MatiasBarreto93/GrupoO-TT/README.md

# GrupoO-TT
Proyecto Final - Ajedrez - Tecnicatura Superior en Programacion - Metodologia de la Investigacion 2022 - UTN Mendoza
