MatiasBarreto93/GrupoO-TT/Covid/Visera Plana/Visera_plana_rapida_1.pdf

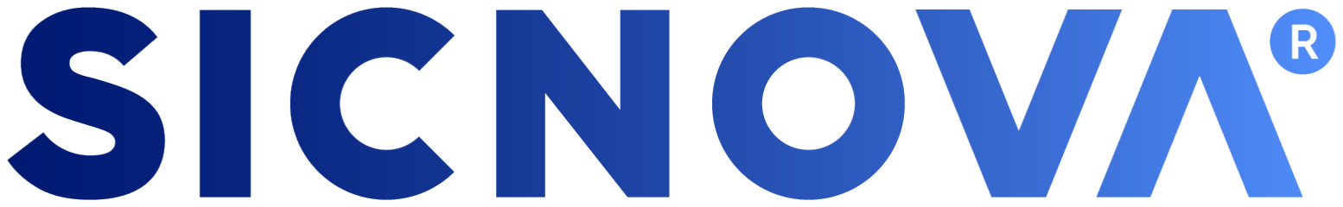
[picture p5: figure]

# Visera plana rápida - protección

antisalpicaduras.

Visera para impresión 3D de fabricación rápida diseñada con el objetivo de prevenir el contagio por la salpicadura que puede generar una persona al hablar o toser. Este sistema se completa acoplando una lámina de acetato de 180 g o similar según indicaciones.

Fuente fichero:

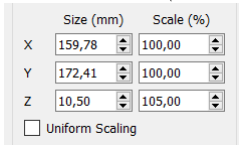
[picture p6: figure]

Tamaño: Se recomienda imprimir con la dimensión en Z escalada (no uniformemente) a 105%.

Material: PLA

Parámetros de impresión
Altura de capa: 0.25 mm (nozzle 0.4) y 0.3 mm (nozzle 0.6) Capas superiores: 2
Capas inferiores: 2
Relleno: 50 %
Soporte: No
Velocidad 60 mm/s

Tiempo de impresión aprox:
- nozzle 0.4 con 0.25 de altura de capa: 55 min

### - Nozzl 0.6 con 0.3 de altura de capa: 29 min

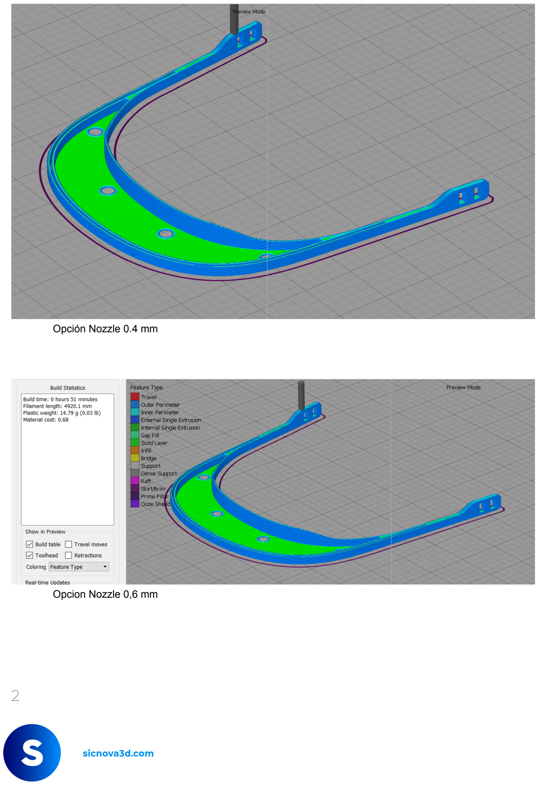
[picture p7: page 2]

Opción Nozzle 0.4 mm

Opcion Nozzle 0,6 mm

2

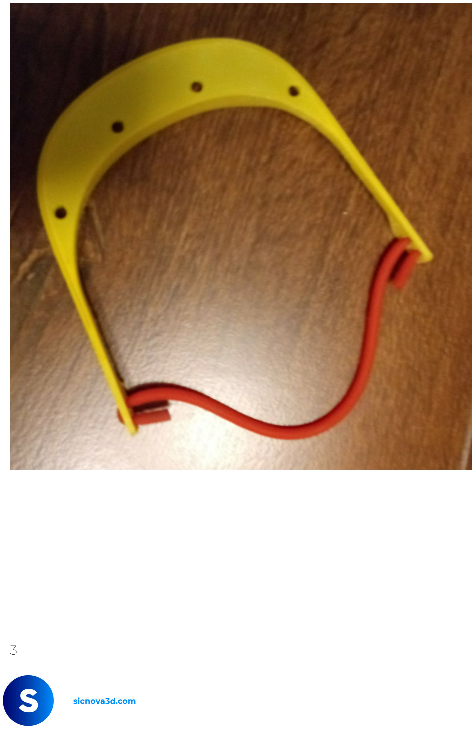
[picture p8: page 3]

3
