MatiasBarreto93/GrupoO-TT/Covid/Visera Completa/VISERA_COMPLETA_V1_2.png

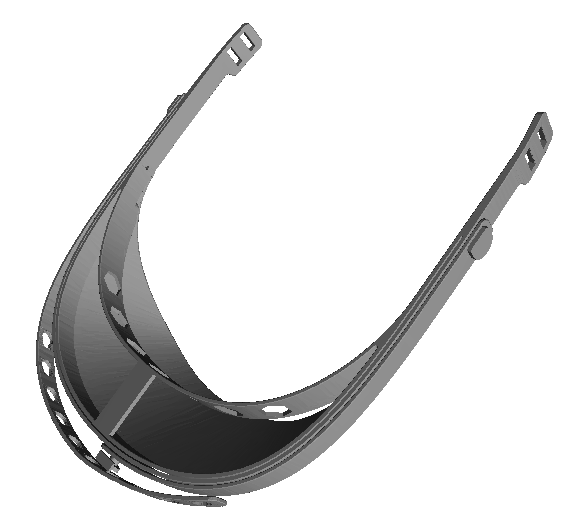
Covid/Visera Completa/VISERA_COMPLETA_V1_2.png
