MatiasBarreto93/GrupoO-TT/Covid/Visera Plana (B)/Arandelas Visera Madrid-Aprobada 1.0.png

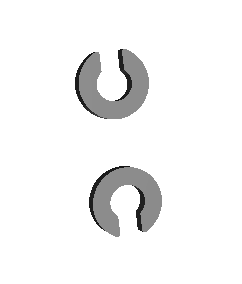
Covid/Visera Plana (B)/Arandelas Visera Madrid-Aprobada 1.0.png
