MatiasBarreto93/GrupoO-TT/Covid/Visera Plana/Visera plana con ventilacion.png

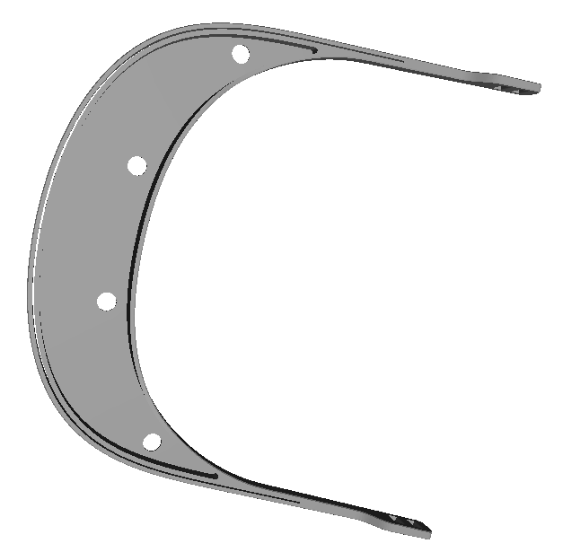
Covid/Visera Plana/Visera plana con ventilacion.png
