MatiasBarreto93/GrupoO-TT/Covid/Visera Completa/VISERA_COMPLETA_v1_2.stl

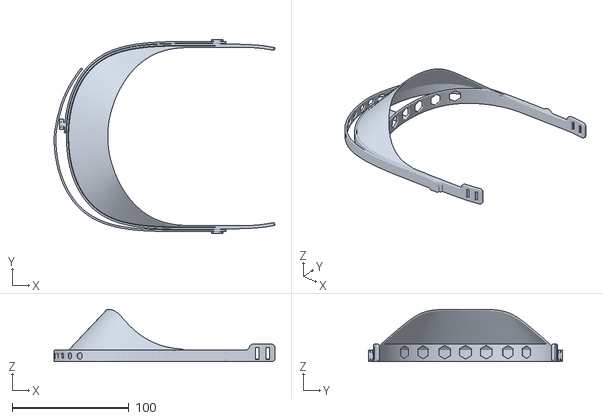
[picture p13: CAD file, 2022-05-04]
Covid/Visera Completa/VISERA_COMPLETA_v1_2.stl
189.0 x 166.3 x 44.7
