MatiasBarreto93/GrupoO-TT/Covid/Visera Plana (B)/B1 Visera Madrid-Aprobada 1.0.stl

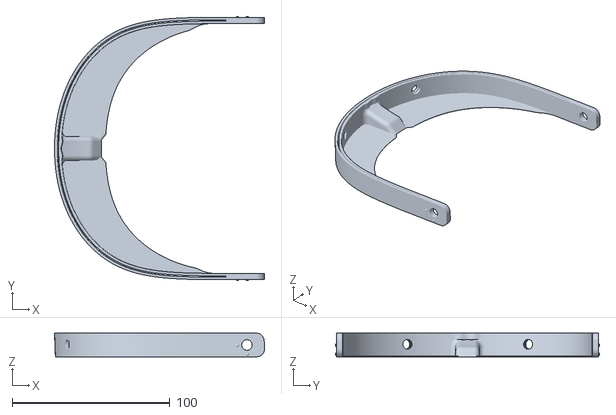
[picture p14: CAD file, 2022-05-04]
Covid/Visera Plana (B)/B1 Visera Madrid-Aprobada 1.0.stl
133.2 x 167.8 x 15.0
