MatiasBarreto93/GrupoO-TT/Covid/Visera Plana/Visera plana con ventilacion.stl

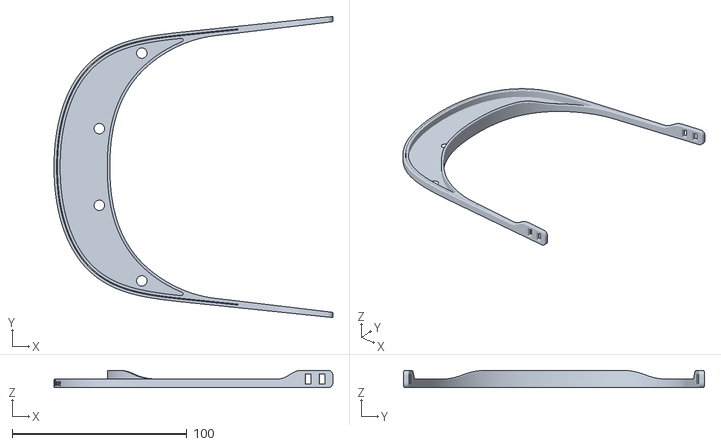
[picture p15: CAD file, 2022-05-04]
Covid/Visera Plana/Visera plana con ventilacion.stl
159.8 x 172.4 x 10.0
