MatiasBarreto93/GrupoO-TT/Covid/Visera Plana (B)/Arandelas Visera Madrid-Aprobada 1.0.stl

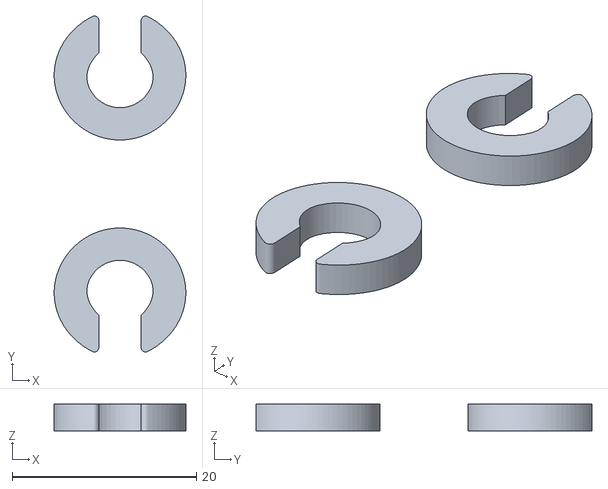
[picture p16: CAD file, 2022-05-04]
Covid/Visera Plana (B)/Arandelas Visera Madrid-Aprobada 1.0.stl
14.3 x 36.5 x 2.90
