MatiasBarreto93/GrupoO-TT/Covid/Visera Completa/Manual_de_Fabricacion.pdf

Página 1

## Documentación de Información

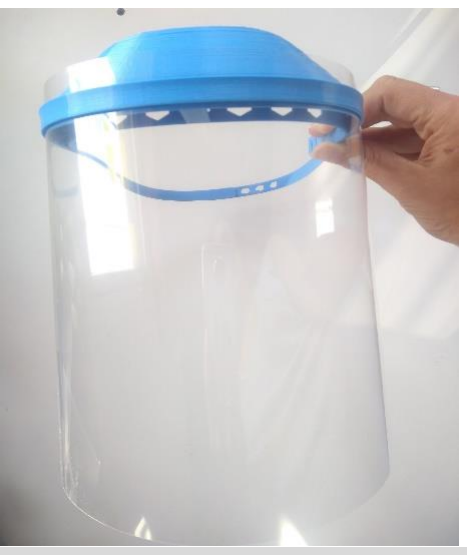
[picture p17: figure]

# MANUAL DE FABRICACIÓN DE

# Máscara Facial

## Guía con instrucciones para la fabricación segura y eficaz de una

máscara facial elaborada mediante tecnología de impresión 3D.

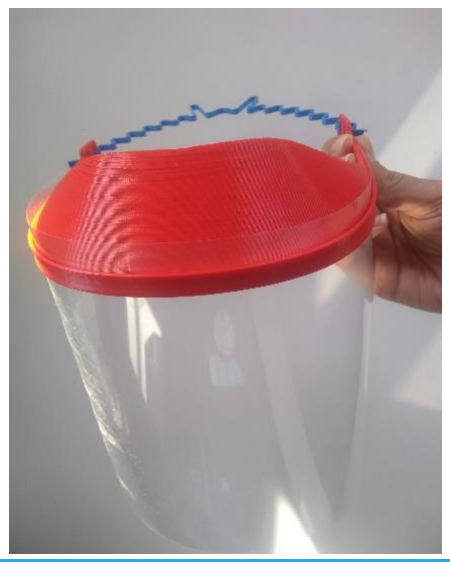
[picture p18: figure]

Versión 1.0.

Última actualización 26/03/2020 @23.00

Página 2

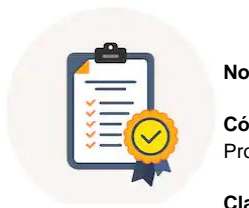
[picture p19: figure]

Nombre descriptivo: MÁSCARA FACIAL.

Código de identificación y nombre técnico UMDNS: 11-961. Protector de las salpicaduras para la cara.

Clase de Riesgo: Clase I (Regla 1)

Uso previsto: Proteger al usuario de gérmenes y partículas originadas por terceros (aerosoles, fluidos corporales).

Fundamento de funcionamiento: Proporcionar una barrera física que permita proteger el rostro del usuario de gérmenes y partículas originadas por terceros.

### DESCRIPCIÓN DEL PRODUCTO

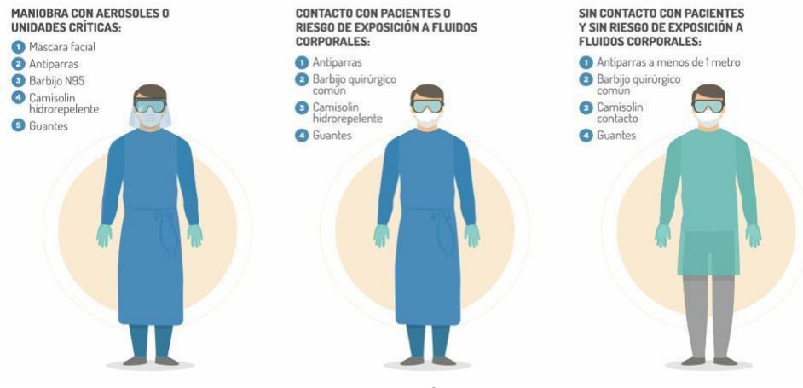
[picture p20: figure]

Página 3

En el contexto de la pandemia generada por COVID-19, numerosos agentes (personal médico o de fuerzas de seguridad) pueden tener contacto con personas infectados y exponerse a la enfermedad. Por eso es fundamental el uso de elementos de protección personal (EPP), que disminuyan la probabilidad de infección.
Concretamente, en el ámbito de la salud, según el nivel de interacción con la persona infectada y el área donde se desempeña una determinada actividad, se utilizarán diferentes EPP (Figura 1).
En particular, las máscaras faciales serán utilizadas por el personal de salud en áreas críticas y/o en aquellas situaciones de riesgo de aerosolización (ej. intubación, broncoscopia, maniobras kinesiológicas,etc) en donde además del aislamiento de gota y aislamiento de contacto, se agrega aislamiento respiratorio. Esto último implica que la persona además de utilizar el protector facial, las antiparras, barbijo N95, camisolin hidrorepelente y guantes debe incluir este elemento en el equipamiento.
Con esto se recalca el hecho de que este método de protección es un elemento más que junto a otros integran el EPP que según normativas de la OMS, del ministerio de salud, y de laS diferentes sociedades científicas son el estándar mundial de cuidados para estos gérmenes.
Debido a una difusión masiva de las máscaras de protección facial, se formó un grupo compuestos por bioingenieros, médicos terapistas e infectólogos, diseñadores industriales, entre otros, a fin de converger en una máscara acorde a las necesidades y analizar, desde una perspectiva multidisciplinaria, distintos aspectos que se deberían tener en cuenta con respecto al diseño y a la impresión de estas máscaras tomando los recaudos de higiene y seguridad apropiados. Como efectores de la salud nos sentimos responsables en dar una respuesta y advertir sobre aspectos de higiene y seguridad que inciden directamente sobre la salud de los trabajadores y la propagación de la enfermedad.

Figura 1: Equipo de protección personal [1].

### INTRODUCCIÓN

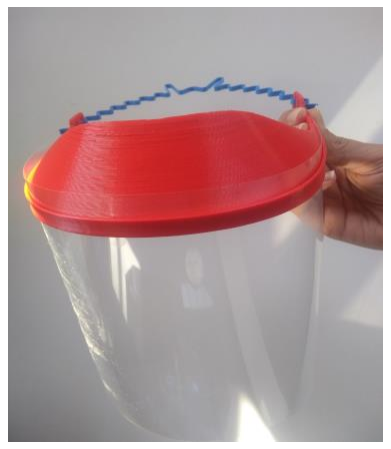
[picture p21: figure]
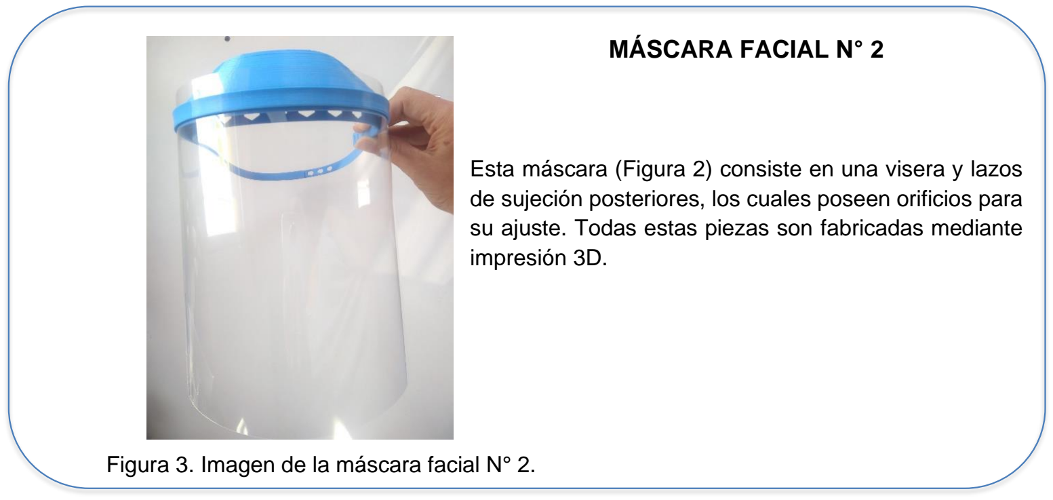
[picture p22: figure]
MÁSCARA FACIAL N° 2; impresión 3D.

Página 4

Se proponen dos modelos de máscaras, a fin de que cada usuario analice cuál se adapta mejor a sus necesidades o le resulta más cómoda para su uso. En base al feedback por parte del personal de salud se realizarán posteriores modificaciones según se crea conveniente

MÁSCARA FACIAL N° 1

Esta máscara (Figura 2) está formada por una visera y como modo de sujeción emplea un “elástico” , ambos fabricados mediante impresión 3D.

Figura 2. Imagen de la máscara facial N° 1.

Esta máscara (Figura 2) consiste en una visera y lazos de sujeción posteriores, los cuales poseen orificios para su ajuste. Todas estas piezas son fabricadas mediante

Figura 3. Imagen de la máscara facial N° 2.

### 1. DESCRIPCIÓN DE LAS MÁSCARAS

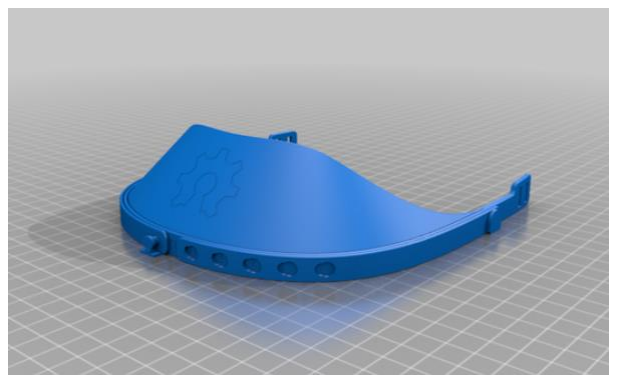
[picture p23: figure]
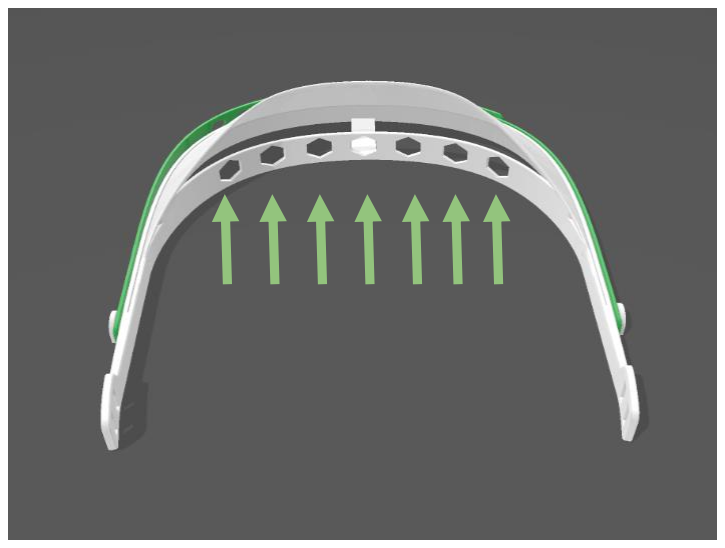
[picture p24: figure]

Página 5

Para generar los diseños propuestos, se trabajó a partir de un diseño libre de base, de una máscara facial (https://www.thingiverse.com/thing:4230817 ) sobre la cual se realizaron una serie de modificaciones.

Figura 4. Mascara de base.

Se consideró que este modelo brinda las características más apropiadas para la aplicación, tales como el sistema de sujeción, libre de elementos textiles y la curvatura superior cerrada, que brinda protección contra el ingreso de fluidos que puedan provenir de la parte superior de la visera. Otro aspecto determinante para la elección de este modelo fue el mecanismo de calce de la placa transparente, el cual resultó simple y evita que se tenga que manipular el film para hacerle los orificios requeridos en otros modelos. En cuanto a las modificaciones realizadas, las mismas se enumeran a continuación.

Orificios en interfaz piel-máscara. Con el objetivo de minimizar la sudoración, se agregaron orificios en la porción de la visera que se encuentra en contacto con la frente del usuario (Figura 5).

Figura 5. Las flechas verdes señalan los orificios propuestos.

### 1.1 CONSIDERACIONES DE DISEÑO

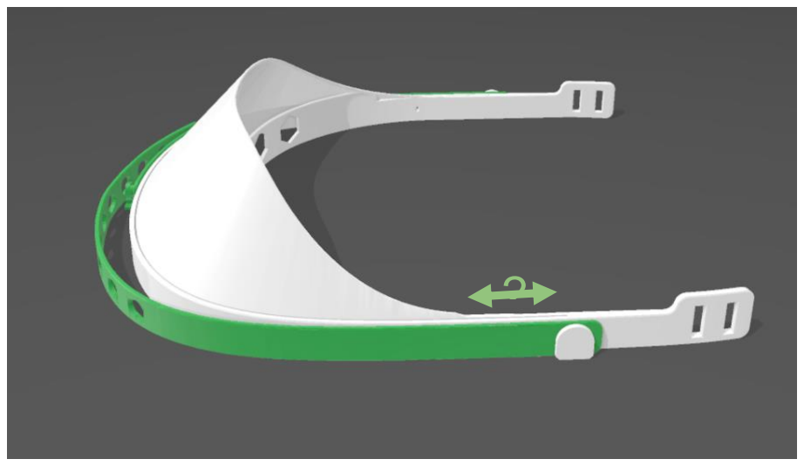
[picture p25: figure]
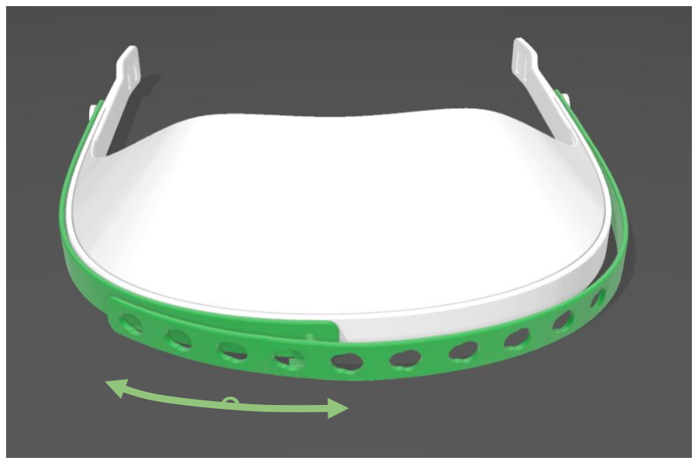
[picture p26: figure]

Página 6

Modificación de tiras de ajuste. Se realizaron modificaciones sobre los lazos a fin de que estos mismos sean empleadas como modo de sujeción de la máscara. Para lograr ésto, se alargaron las tiras a cada lado en un total de 2 cm (Fig. 6). Además con el objetivo de adecuar el tamaño de la máscara facial a un rango más amplio de usuarios, se aumentó el perímetro de la visera, añadiendo 6 cm de longitud a la tira hembra (Fig. 7).

Figura 6. Alargue de tiras en 2 cm.

Figura 7. Alargue de tira hembra en 6 cm.

Refuerzo anterior para evitar deformaciones. Al colocar el film transparente y simular las distintas maniobras de movimientos de los usuarios, se percibió una inestabilidad de la parte de la máscara que sujeta la pantalla, es por esto que se decidió agregar un soporte conector que aumente la fijación y por ende proporcione mayor estabilidad (Fig. 8).

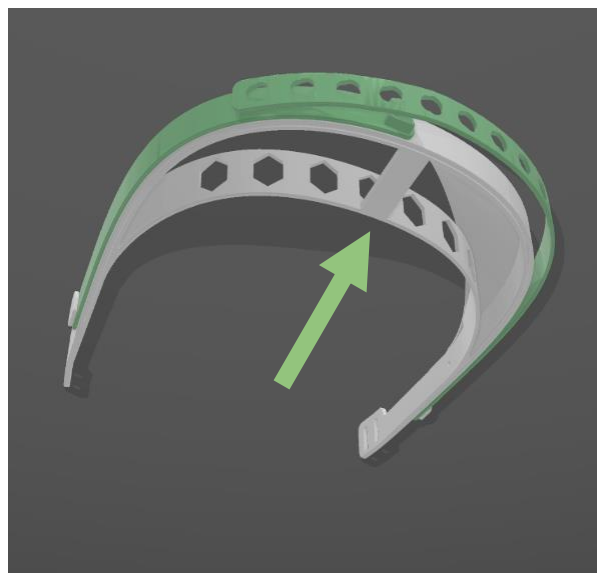
[picture p27: figure]
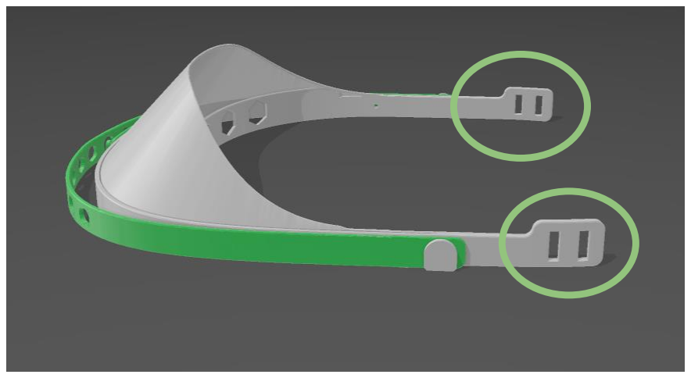
[picture p28: figure]

Página 7

Figura 8. La flecha verde señala el refuerzo anterior añadido.

Alternativa de Sujeción. Luego de consultar a expertos infectólogos, se objetó el uso de un elástico textil como material para la sujeción de las máscaras, debido a que no puede esterilizarse ni desinfectarse correctamente. Es por esto que los dos modelos propuestos incluyen un método de ajuste impreso en 3D.
De todas formas, considerando que la sujeción impresa en 3d podría romperse con el uso reiterado, la máscara posee unos orificios para colocar un elástico (se recomienda goma vulcanizada de uso médico), en caso de que se transite una situación de urgencia y no haya otra alternativa. Si así fuera, el elástico debe reemplazarse en cada desinfección de la máscara.

Figura 9. Orificios para calce de elástico.

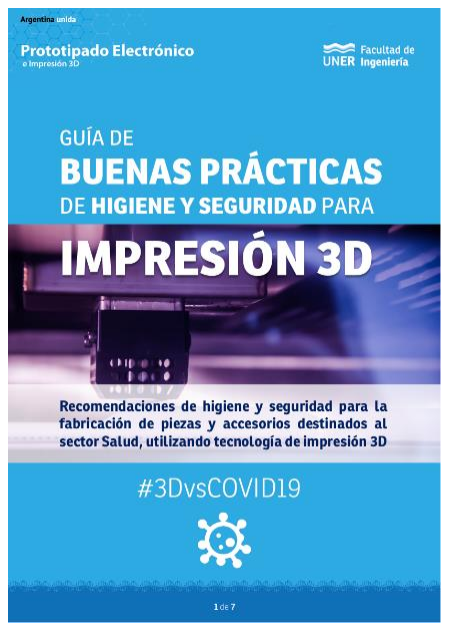
[picture p29: figure]

Página 8

Antes de comenzar con el procedimiento de impresión, es importante que se lean con atención las pautas de higiene y seguridad a tener en cuenta para la manufactura de los productos elaboradas por nuestro equipo de trabajo.

A continuación se exponen los ítems más relevantes sobre los que hay que prestar mayor atención de la guía antes mencionada.
- Actuar siempre considerando que se puede infectar la pieza en fabricación.
- Utilizar guantes y barbijo durante todo el proceso de manufactura.
- Realizar con frecuencia el lavado de manos, empleando agua y jabón o soluciones a base de alcohol.
- Limpiar y desinfectar regularmente todas las superficies de trabajo, para minimizar el riesgo de transmisión por contacto.
- Preparar adecuadamente la impresora, el material de impresión y las superficies de trabajo antes de comenzar a imprimir las piezas.
- EMPAQUETAMIENTO: Se aconseja entregar a los usuarios las máscaras desarmadas dentro de bolsas transparentes limpias y selladas. Para esto, se debe limpiar y desinfectar cada pieza antes de empaquetarla.

### 2. GUIA DE FABRICACION

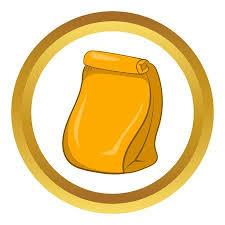
[picture p30: figure]

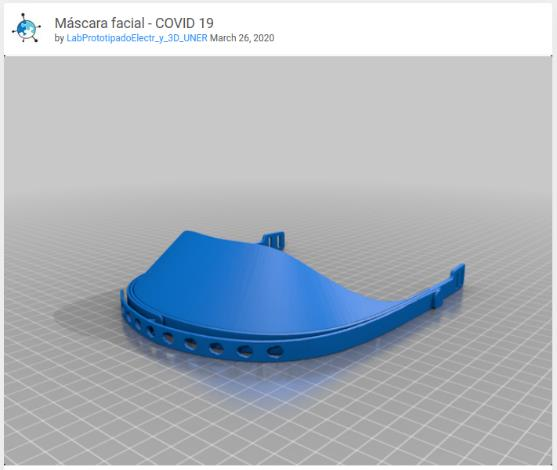
[picture p31: figure]

Página 9

ADJUNTAR a cada lote entregado un rótulo con especificaciones del producto y datos del fabricante (Ver rotulo recomendado en Guía de buenas prácticas de HyS para impresión 3D); además de un manual de instrucciones de uso que brinde información respecto a la desinfección, manipulación, descarte, almacenamiento, entre otros. Para esto último, en el siguiente link (https://covid.ingenieria.uner.edu.ar/course/view.php?id=5&section=4) se encuentra disponible un “MANUAL DEL PRODUCTO” para el usuario. Este documento tiene que ser enviado o entregado al personal de salud que recibirá las máscaras. Se recomienda que haya un responsable que se encargue de capacitar a los usuarios.

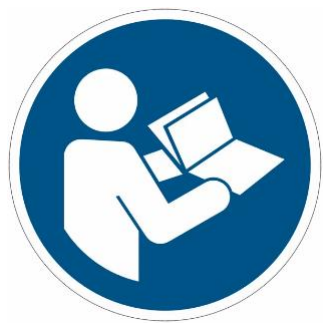
[picture p32: figure]

En el siguiente enlace se encuentran disponibles los archivos de descarga para las máscaras mencionadas.

MÁSCARA N°1: Para su confección necesitará imprimir dos archivos.
- Visera_sin_sujecion.stl: Cantidad de material: 34 grs; Tiempo estimado de impresión: 2:30 hs
- Elástico.stl: Cantidad de material: 2 grs; Tiempo estimado de impresión: 8 min

### 2.1. MODELOS 3D

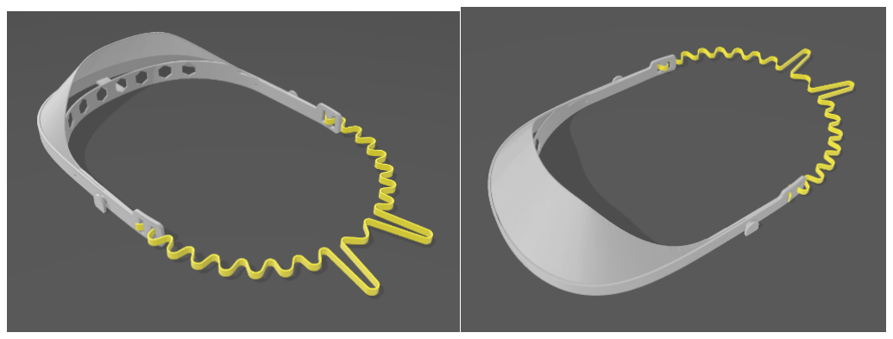
[picture p33: figure]
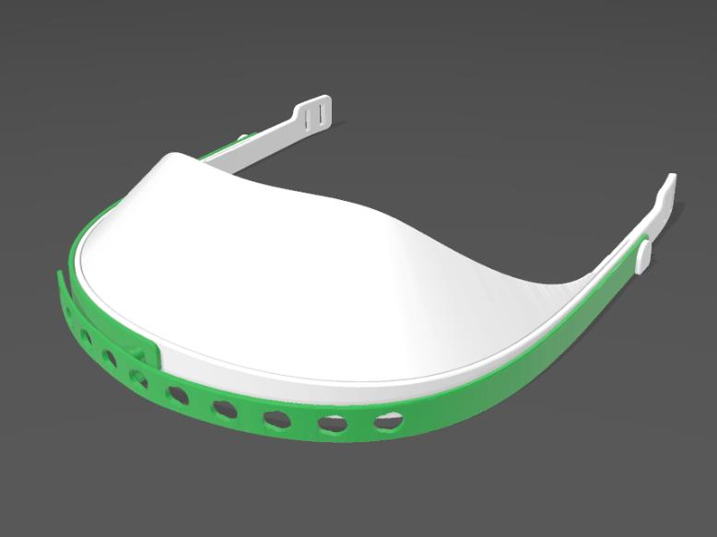
[picture p34: figure]

Página
10

MÁSCARA N° 2: Para su elaboración solo deberá imprimir un solo archivo
- visera_completa.stl. Cantidad de material: 42 grs; tiempo estimado de impresión: 3 hs.

Pantalla Transparente:
El material que se utilice debe ser un polímero transparente que asegure una buena visibilidad.
- Material sugerido: Placas de acetato, PET o PETg, policarbonato, PVC.
- Espesor: min 200 um - max 1mm (para asegurar que la fijación de la pantalla a la visera sea apropiada).
- Tamaño mínimo 25 (largo) x 30 (ancho) cm
- Tamaño máximo de 35 (largo) x 34 (ancho) cm

Página
11

### 2.2.1 Impresión 3D (esto aplica para ambas máscaras y el elástico)

- Para la impresión se recomienda utilizar como materiales de impresión PETG, para que la visera sea lo suficientemente flexible para el ensamble y uso final.
- Se recomienda que solo se use PLA para realizar las pruebas preliminares del diseño, pero no para el modelo a ensamblar y usar ya que no cuenta con la resistencia mecánica necesaria para el uso previsto del producto.

Propuesta de parámetros de impresión:

- Nozzle de 0.4mm
- Temperatura de nozzle: 215ºC
- Temperatura de cama: 70ºC
- 3 perímetros
- Relleno 100%
- 0.3 mm altura de capa
- 60 mm/s (relleno, perímetros interiores y exteriores, piso y techo)

### 2.2.2 Acondicionamiento de pantalla transparente

Recortar las puntas del extremo libre de la pantalla, para brindarle una forma redondeada, con el objetivo de evitar daños en el usuario.

### 2.2. MÉTODOS

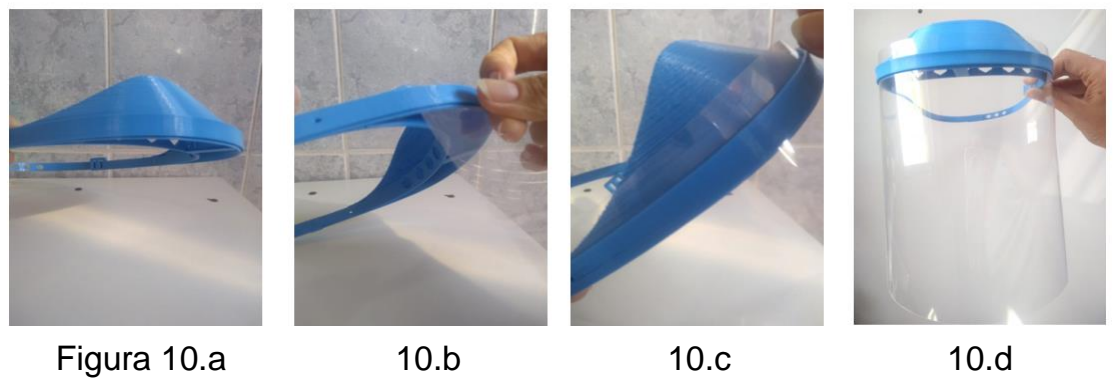
[picture p35: figure]
Figura 10.a
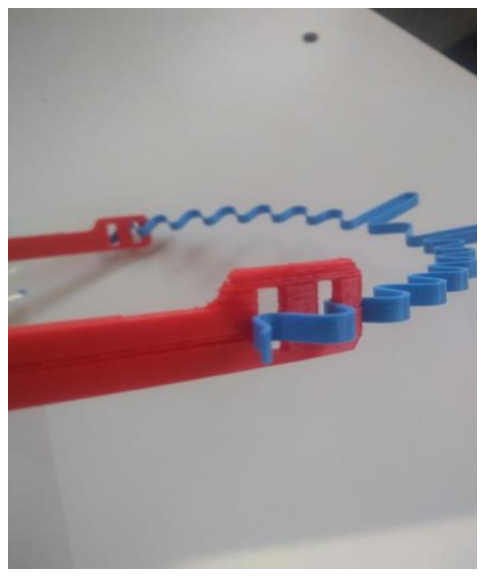
[picture p36: figure]

Página
12

Si bien en la guía de buenas prácticas se sugiere entregar la máscara desarmada en bolsas individuales y correctamente higienizadas, a continuación, se describe el ensamblaje de la máscara a fin de que el fabricante entienda el proceso de armado, para de esta forma asesorar al usuario.

a. Introducir la pantalla transparente por la ranura (Fig. 10.a y b).
b. La pantalla deberá sobresalir como mínimo 1 cm, a fin de asegurar que la misma quede fija sobre el calce de la visera (Fig. 10.c).
c. Asegurar que la pantalla quede centrada, para que la protección sea simétrica en ambos lados (Fig. 10.d).
a. En caso de poseer una máscara con un método de sujeción tipo elástico, introducir el elástico posterior y el de fijación por las ranuras de la máscara (Fig. 11.a).
b. Asegurar que el elástico quede centrado, para que la protección sea simétrica en ambos lados (Fig. 11.b).

### 2.3. ENSAMBLAJE DE LA MÁSCARA

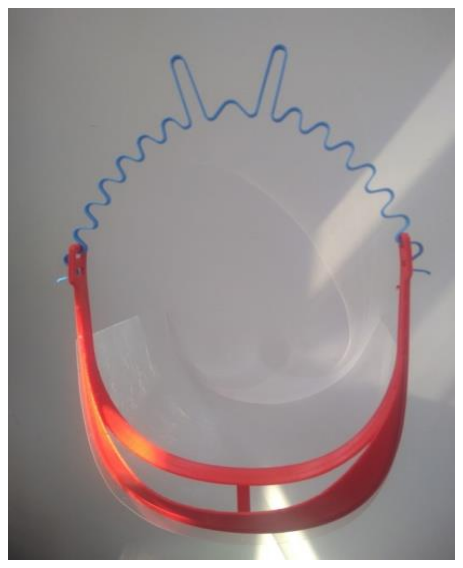
[picture p37: figure]

Figura 11.a | 11.b

Página
13

Para asegurar el funcionamiento seguro y eficaz en este contexto, el producto debe cumplir con la directiva de la UE estándar 86/686/CEE, UNE-EN 166:2002, ANSI/ISEA Z87.1:2010, o equivalente.

prototipado@ingenieria.uner.edu.ar / sofiadropsi@gmail.com

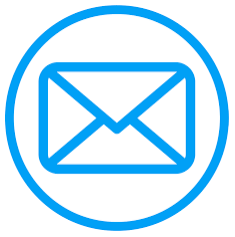
[picture p38: figure]

REFERENCIAS

[1] https://www.fcchi.org.ar/covid19/
[2] https://www.dach-germany.de/media/pdf/f7/68/ca/265-Technisches-Datenblatt-DE.pdf
[3] https://www.paho.org/hq/index.php?Itemid=270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 (https://www.paho.org/hq/index.php?option=com_docman&view=download&Itemid=270&lang=es)

### NORMATIVA

### CONTACTOS

### REFERENCIAS
