MatiasBarreto93/GrupoO-TT/(commit log)

2022-05-29 Ultima prueba antes de empezar
2022-06-05 Jugada de enroque
